centuri-engineering/M2_CIML_Automated-image-capture/drawings/cam_mask.png

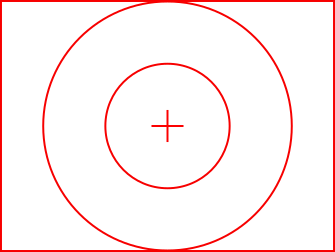
drawings/cam_mask.png
