centuri-engineering/M2_CIML_Automated-image-capture/drawings/electronics.png

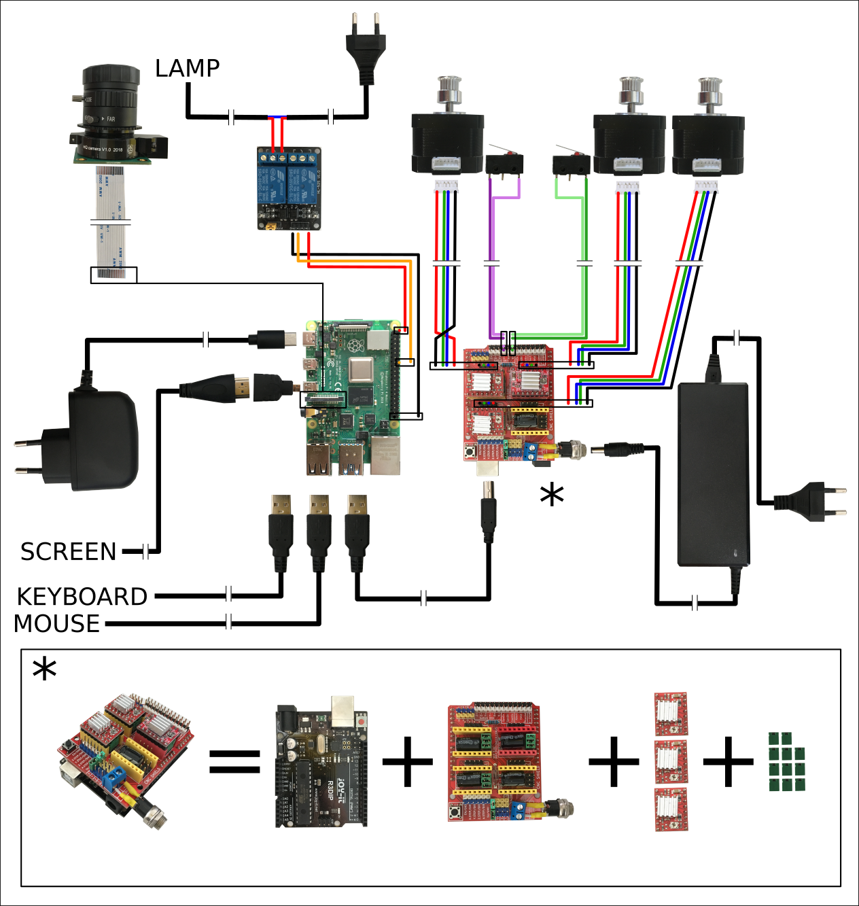
drawings/electronics.png
