centuri-engineering/M2_CIML_Automated-image-capture/drawings/scheme.png

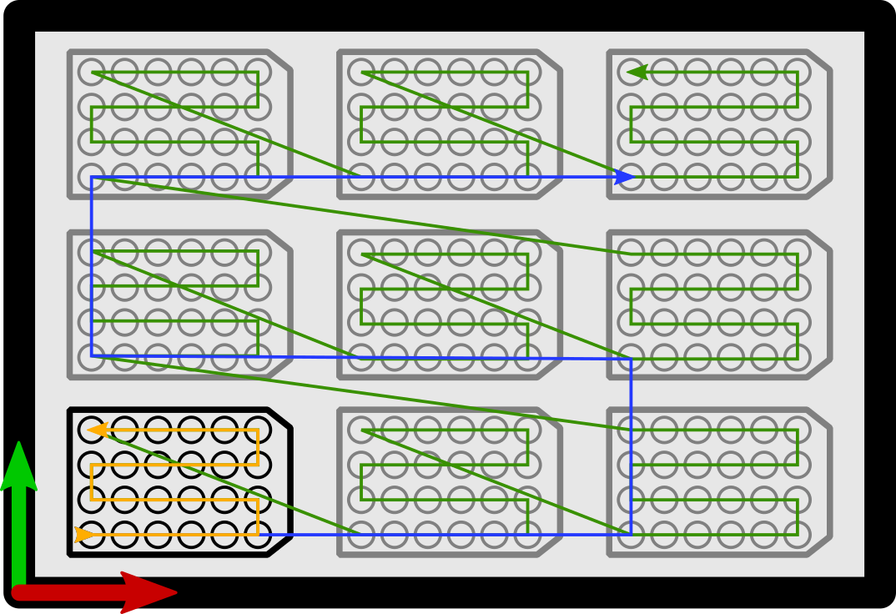
drawings/scheme.png
