centuri-engineering/M2_CIML_Automated-image-capture/(threads)

Thread 9 (2021-04-06):

Kivy UI : current position with extremely long floating numbers

mathiaslec, 2021-04-06:
Issue : the "current position" on the UI shows X and Y positions with long floating numbers.

How to reproduce :
- select "step: 0.1 mm";
- click "Right" 3 times (wait until the motor turn between each click);
- result : "current position: x: 0.30000000000000004, y: 0"

glyg, 2021-04-27:
fixed by 4585224

Closed 2021-04-27.

Thread 13 (2021-05-06):

running scan problems

glyg, 2021-05-06:
- [ ] Maintain preview while scanning
- [ ] prevent new scanning thread to start (aka deactivate scan button)

Thread 14 (2021-05-06):

UI enhancements

glyg, 2021-05-06:
- [ ] expose camera settings
- [ ] expose well settings
- [ ] display wells in main view (with current camera position?)
- [ ] calibrate well pos vs camera pos

Thread 15 (2021-05-21):

Motors stop running

mathiaslec, 2021-05-21:
Check the endswitches soldering.

mathiaslec, 2021-07-19:
Adjusted the threshold of the 3 stepper drivers.
Also the Y stepper motor was always stopping at the same place, and seems to be damaged. We replaced it with a similar NEMA 17.

Closed 2021-07-19.
