centuri-engineering/M2_CIML_Automated-image-capture/Arduino/grbl_config.txt

Current settings (working) :

$0=10
$1=25
$2=0
$3=1
$4=0
$5=1
$6=0
$10=0
$11=1.000
$12=0.002
$13=0
$20=0
$21=1
$22=1
$23=3
$24=25.000
$25=500.000
$26=250
$27=1.000
$30=1000
$31=0
$32=0
$100=80.000
$101=80.000
$102=250.000
$110=8000.000
$111=8000.000
$112=500.000
$120=500.000
$121=500.000
$122=10.000
$130=500.000
$131=500.000
$132=200.000


Original settings for the Arduino Firmware:

Grbl 1.1f ['$' for help]
$0=10
$1=25
$2=0
$3=0
$4=0
$5=0
$6=0
$10=1
$11=1.000
$12=0.002
$13=0
$20=0
$21=0
$22=0
$23=0
$24=25.000
$25=500.000
$26=250
$27=1.000
$30=1000
$31=0
$32=0
$100=80.000
$101=80.000
$102=250.000
$110=8000.000
$111=8000.000
$112=500.000
$120=500.000
$121=500.000
$122=10.000
$130=500.000
$131=500.000
$132=200.000

To see the settings in the Arduino IDE Monitor, make sure the baudrate is set to 115200 (with GRBL 1.1), and "Cariage return" selected;
Type $$ and type Enter (or click Send) in sending bar of the monitor.
More info about this here : https://github.com/gnea/grbl/wiki/Grbl-v1.1-Configuration

Limit switches normally-closed (NC) added, therefore $5=1
