centuri-engineering/M2_CIML_Automated-image-capture/(commit log)

2020-12-02 add camera preview size
2020-12-03 Code working and ready to publish on Centuri account
    [grbl_config.txt]
2020-12-03 Fix loop prob in camera_control function
    [functions.py]
2020-12-03 switch x and y nb_well on dict box
2020-12-07 NC limit switch added, grbl config modified
    [grbl_config.txt]
2020-12-07 Hard limit + homing on grbl config
    [grbl_config.txt]
2020-12-07 grbl settings updated
    [grbl_config.txt]
2020-12-07 Change microcontroler board
2020-12-07 Add relay command
2020-12-07 add homing gcode sequence
2020-12-09 relay + limit switches + cam : working
    [grbl_config.txt]
2020-12-09 remove a print()
2021-02-05 new res
    [grbl_config.txt]
2021-04-27 bug fixes with camera handling
    [kivy_ui.py, scanner.py]
2021-04-27 bettter positions labels, fixes #1
    [config.py, functions.py, kivy_ui.py, scanner.py]
